ljy980330/51_development_board/README.txt

51开发板项目 GitHub仓库说明

datasheet
    所有的数据手册

hardware
    硬件组项目目录

software
    软件组项目目录

例会讲稿
    每次例会用到的文件

开支
    项目开支流水
