ljy980330/51_development_board/software/初级例程/015 ADC/readme.txt

delay.c :	延迟功能所用到的函数
ADC：	ADC转换的初始化与实现函数
