ljy980330/51_development_board/software/初级例程/021 步进电机/readme.txt

display：		数码管对应的函数
stepperMotor：	步进电机对应的函数
