ljy980330/51_development_board/software/初级例程/017 DAC/readme.txt

PWM文件夹是用来储存AD转换初始化以及输出数据的C源码与头文件

dalay文件夹是用于存放公用的延时函数

Listings文件夹包含了编译所有中间文件

Objects文件夹包含了编译出来的文件（包括最终烧录进单片机的hex文件）

LEDindicator.uvproj 是该程序的工程文件

config.h包含了所有的类型的声明和定义

includes.h包含了所有的头文件

main.c是主函数C源码
