ljy980330/51_development_board/software/初级例程/012 温度传感器/readme.txt

code_tab：	16进制数组存放
function：	OLED模块功能
drive：		数据采集和系统初始化
display：		OLED屏幕显示
i2c：		I2C通信驱动模块
