ljy980330/51_development_board/software/底层驱动/001 I2C驱动/readme.txt

i2c驱动程序

delay：
		延时函数
		
i2c_set:
		i2c初始化以及信号发送和读写字节
