ljy980330/51_development_board/software/中级例程/001 I2C协议-OLED屏幕/readme.txt

OLED屏幕显示

code_tab:
		屏幕显示的值
		
delay：
		延时
		
display：
		屏幕显示
		
function：
		屏幕写命令，写数据，设置坐标，全屏模式，复位
		
i2c：
		i2c通信协议
		
OLED_Init:
		屏幕初始化
