ljy980330/51_development_board/software/高级例程/003 万年历/readme.txt

rtc	:时钟模块
oled	:屏幕模块
iic	:i2c驱动
delay	:延迟函数
