ljy980330/51_development_board/software/中级例程/002 SPI协议-无线模块/send/readme.txt

send_main：发送函数
receive_main：接受函数
spi：spi驱动
UART：UART驱动
