ljy980330/51_development_board/hardware/190711/STC12C5A60S2/20190522.PcbDoc.htm

Reporting Options

# File in Previous Format

Date | : | 2019/9/7
Time | : | 12:32:29
Filename | : | D:\Users\DELL\Documents\GitHub\51_development_board\hardware\190711\STC12C5A60S2\20190522.PcbDoc

Version | Warning

This file was generated by an earlier version of the software
