ljy980330/51_development_board/hardware/190726/STC12底板 190726/STC12C5A60S2底板.PcbDoc.htm

Reporting Options

# File in Previous Format

Date | : | 2019/9/6
Time | : | 19:30:06
Filename | : | D:\Users\DELL\Documents\GitHub\51_development_board\hardware\190726\STC12뒀겼 190726\STC12C5A60S2뒀겼.PcbDoc

Version | Warning

This file was generated by an earlier version of the software
