ljy980330/51_development_board/hardware/190715/STC12底板 190715/STC12C5A60S2底板.PcbDoc.htm

Reporting Options

# File in Previous Format

Date | : | 2019/9/6
Time | : | 20:45:48
Filename | : | D:\节能院\51开发板项目\github\51_development_board\hardware\190715\STC12底板 190715\STC12C5A60S2底板.PcbDoc

Version | Warning

This file was generated by an earlier version of the software
