ljy980330/51_development_board/software/项目分配.docx

1) 点亮一个LED灯...........................................剑桥
2) LED灯闪烁
3) LED流水灯
4) 蜂鸣器
5) 独立按键
6) 外部中断
7) 定时器中断
8) 红外模块
9) 静态数码管显示
10) 动态数码管显示
11) 超声波模块
12) 光敏……………………………………………………………思茹
13) ADC
14) DAC
15) PWM
16) 呼吸灯
17) 直流电机
18) 步进电机
19) RGB灯………………………………………………………..燕婷
20) I2C协议-OLED屏幕
21) OLED屏幕显示ASCII码
22) OLED屏幕显示中文
23) OLED屏幕显示图案
24) 屏幕+温度显示
25) 屏幕+RTC显示
26) 蓝牙通信……………………………………………………..彦钊
27) 电子秒表
28) 万年历
29) 智能小车
30) RTC时钟
31) RTC时钟驱动
32) SPI协议-无线模块
33) SPI驱动
34) 串口通信………………………………………………………大鹏
35) I2C驱动
36) UART驱动
37) 温度传感器
38) 温度传感器驱动
