ljy980330/51_development_board/software/readme.txt

github上只上传工程和源文件，所有的编译中间问价和输出文件都提前删掉

keilkilll.bat：每次编译后上传前使用，清除中间文件，缩小工程（直接点击即可）

STC12C5A.H放到keil目录下的\\C51\INC！！
