ljy980330/51_development_board/hardware/190726/read me.txt

  1、底板使用共阴极数码管，软件组程序写的是共阳极。先前在画模块的时候，使用的是共阳数码管，所以在调试的时候可以使用先前打的模块
  2、DS3231芯片的封装图选错与买回来的芯片尺寸不一样
  3、在原理图转PCB时没有把74HC138第六引脚的VCC转过去，导致LED无法正常点亮
  4、步进电机第五个引脚没有接上VCC，蜂鸣器需要加一个4.7KΩ的电阻再接上电源
  5、AD转换模块中，由于在AO口接了电阻，导致输出的电压减小，这样使得AD转换无法正常工作
  6、电源开关原本位于核心板的正上方，导致不方便使用底板的电源开关，故把电源开关往左挪
  7、独立按键的K3使用P4^7口，需要在烧录的时候把烧录界面的复位脚用作IO的选项勾选上
  8、DHT11的DATA脚需要上拉一个4.7K的电阻，否则无法正常使用该模块
  9、由于超声波程序中用到了外部中断0，故把外部中断的按键去掉
