ljy980330/51_development_board/software/中级例程/003 RGB灯/readme.txt

RGB颜色显示
	
	delay：
		延时
	display：
		不同模式的颜色闪烁
