ljy980330/51_development_board/例会讲稿/0704/例子/readme.txt

XXX例程

delay:
    存放延时模块的文件
ir:
    存放红外模块的文件
smgdisplay:
    存放数码管模块的文件
config.h
    变量重定义头文件
includes.h
    所有头文件的集合
main.c
    主函数
