ljy980330/51_development_board/例会讲稿/0313/0313-hardware.txt

硬件组

1.分配好组员的任务，下发模块，以模块为基础研发我们集成进开发板的电路（分配好之后，将模块对应的组员名字发给我）
2.给出最小系统的设计框图（集成USB烧录功能）
3.给出开发板电源设计的方案（包括防反接，过压，过流，短路的保险措施）
4.先做我们没有购买的模块，比如流水灯，独立按键，红外
