ljy980330/51_development_board/例会讲稿/0327/0327第一阶段总结.pptx

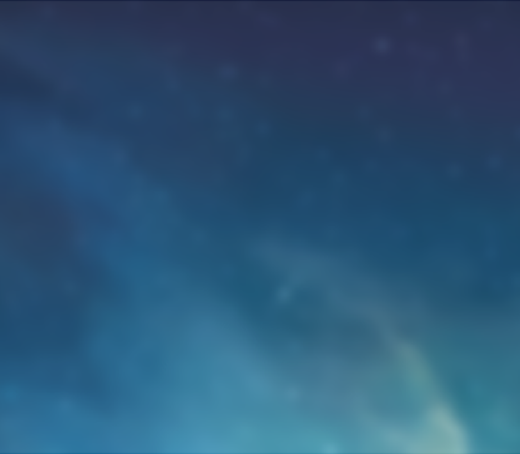
[picture p7: figure]

2019.3.27

51开发板项目
第一阶段总结报告

—梁敬彦

## Slide 2

01

方案进度

02

人员安排

03

软件设计

04

硬件设计

05

未来计划

Your life can be enhanced, and your happiness enriched, when you choose to change your perspective.

## Slide 3

01

方案进度

## Slide 4

01

方案概述

LOGO

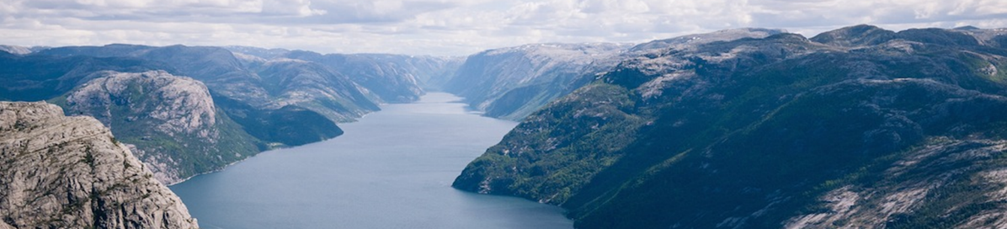
[picture p8: figure]

MCU

该方案使用STC12C5A60S2作为主控芯片，使用外围芯片及电路搭建开发板硬件环境，配套提供软件例程代码。

硬件组
负责开发板的原理图及PCB设计，其中较为复杂的电源方案由组长与副组长给出（包括防反接，过压，过流，短路的保险措施），使用模块化的设计，先测试单个模块，再进行开发板集中组合。

软件组
负责配套例程，底层驱动的设计。使用模块化的设计，各组员负责自己分配的模块，不会出现重复开发的情况。每个模块的软件设计都会生成程序流程图或系统框图。

## Slide 5

01

方案意义

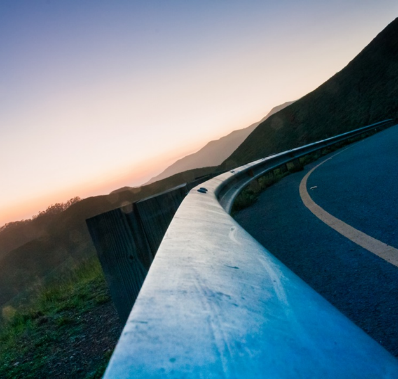
[picture p9: figure]

LOGO

对于大一

参与项目可以学到更多的知识，增强自己的能力

对于大二

不仅需要解决一些高难度的问题，同时作为小组长，如何管理自己的小队也是对自己的一种挑战

对于大三

作为项目组坚实后盾，技术过硬，起着项目带头引导作用

对于节能所

开发板完成后，可以作为后进新生的学习样机，是实验室良性循环不可或缺的一部分

## Slide 6

01

计划进度

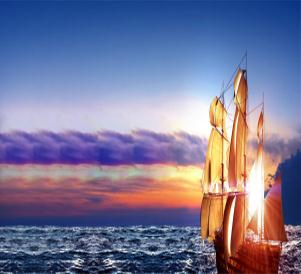
[picture p10: figure]

LOGO

规划、计划阶段

2019.03.01-2019.03.31

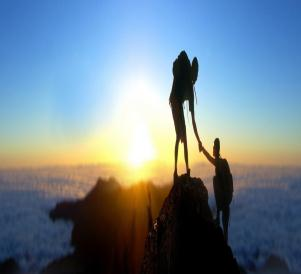
[picture p11: figure]

软硬件开发阶段

2019.04.01-2019.06.30

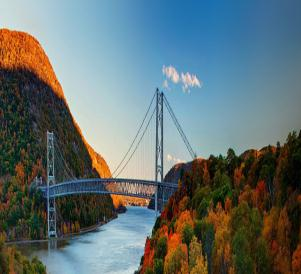
[picture p12: figure]

测试阶段

2019.07.01-2019.08.31

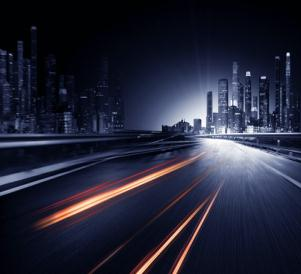
[picture p13: figure]

投产使用阶段

2019.09.01-

## Slide 7

02

人员安排

## Slide 8

01

分组安排

LOGO

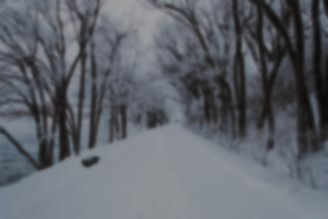
[picture p14: figure]

大三（总负责人）

向指导老师汇报完成进度及项目情况。
推动项目的进行，规划各个小组的设计任务，把握项目的整体走向。对所有元器件进行选型及采购。

大二（小组长）

向总负责人汇报完成进度及项目情况。
软件组：负责高级例程、底层驱动代码的编写
硬件组：负责整机的原理图和PCB设计，汇总组员的设计结果。
测试组：负责压力测试和极限测试，汇总组员的测试结果。

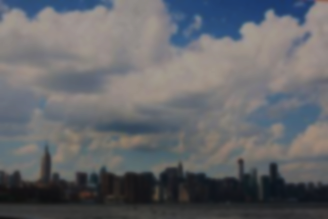
[picture p15: figure]

大一（组员）

向小组长汇报完成进度及项目情况。
软件组：负责中级、初级例程代码的编写
硬件组：负责单个模块的原理图和PCB设计
测试组：负责测试单个模块的性能指标

## Slide 9

01

人员安排

LOGO

部门 | 职位 | 人员信息
软件组 | 组长 | 张大鹏
| 副组长 | 詹锌铠 黄彦钊
| 组员 | 曾思茹 吴彦婷 黄剑桥
硬件组 | 组长 | 林彦妤
| 副组长 | 彭星天 郑泽鹏
| 组员 | 李诗琪 陈建洲
测试组 | 暂无 | 暂无

说明：测试组人员由暑假留校人员组成

## Slide 10

03

软件设计

## Slide 11

03

软件例程

LOGO

04

高级例程

蓝牙通信，万年历，智能小车等4个例程

02

初级例程

流水灯，蜂鸣器，中断等21个例程

05

底层驱动

I2C，SPI，UART等5个驱动

01

准备教程

包括keil软件的安装、CH340驱动安装、如何使用ISP软件烧写程序。

03

中级例程

OLED屏幕等8个例程

## Slide 12

03

硬件组汇报

LOGO

下面由软件组组长进行项目汇报

## Slide 13

04

硬件设计

## Slide 14

03

各模块设计

LOGO

计划在开发板上实现14个功能模块，包括数码管、流水灯、步进电机、蜂鸣器、独立按键、温度传感器、红外接收器、RTC时钟、超声波、无线接收、UART、USB烧录、ADC采集、OLED显示、光敏DAC采集、RGB灯。

陈建州

数码管模块
步进电机模块
RTC模块

李诗琪

流水灯模块
蜂鸣器模块
独立按键模块
红外模块

林彦妤

温度模块
光敏模块
RGB灯模块

彭星天

烧录模块
其他

## Slide 15

03

硬件组汇报

LOGO

下面由硬件组组长进行项目汇报

## Slide 16

05

未来计划

## Slide 17

02

未来计划

LOGO

75%

15%

ADD YOUR TITLE

软件组长
完成中级及高级例程的代码编写，绘制程序流程图。并指导组员完成初级例程的编写。
在完成功能的基础上要争取无软件BUG。

ADD YOUR TITLE

软件组员
完成初级例程，做好注释，代码规整。各组员之间互相协助，有问题多问，在完成项目的同时巩固自己的基础。

50%

ADD YOUR TITLE

硬件组长
完成电源的制作及验证，确保电源的安全性和高效性。组合各个模块，分配好开发板的资源空间（包括布局美观，使用方便，不易损坏，走线合理性）。并指导组员完成各模块的设计。

60%

ADD YOUR TITLE

硬件组员
完成各模块的硬件设计任务，确保模块在硬件上没有问题，并交由软件组进行开发及测试。加强自己在硬件设计及PCB layout方面的能力。

## Slide 18

2019.3.27

THANK YOU
