ljy980330/51_development_board/例会讲稿/0529/0529硬件组第三次报告.pptx

## 硬件组五月汇报

2019.5.29

## 进度：

- 电压正常输入5V，电流为4mA
- 最大耐压值为9V，电流为10mA
- 当输入电压为10V的时候，电流突破20mA,芯片烧坏
- 核心板的冷启动失败

## 解决方案:

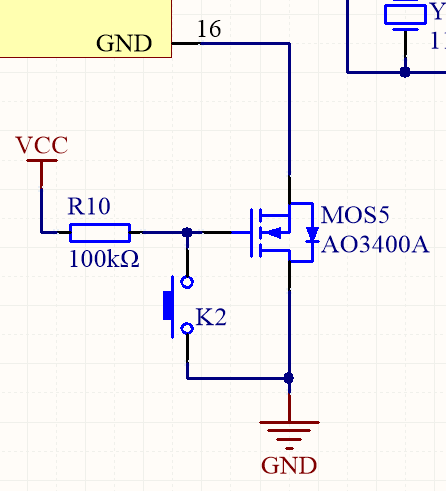
[picture p22: figure]

## Slide 4

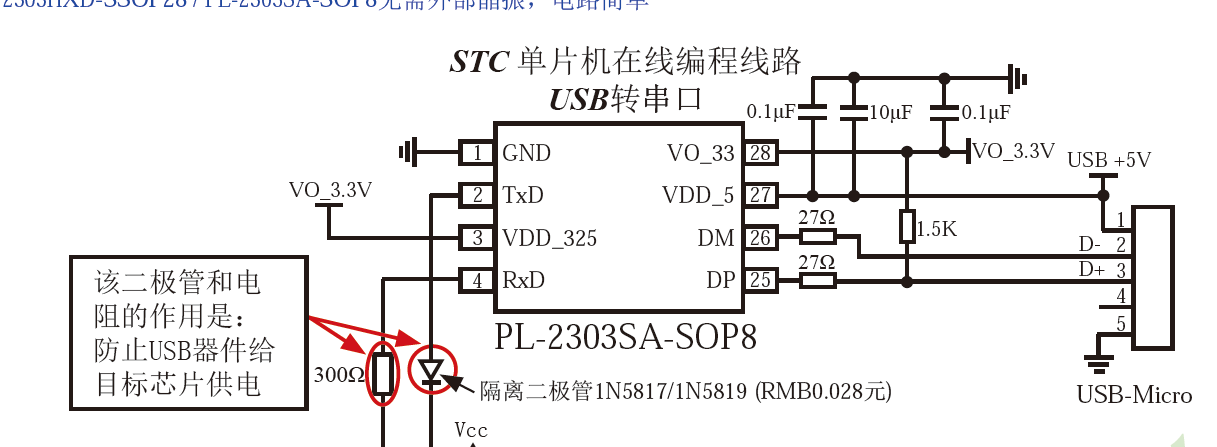
[picture p23: figure]

## Slide 5

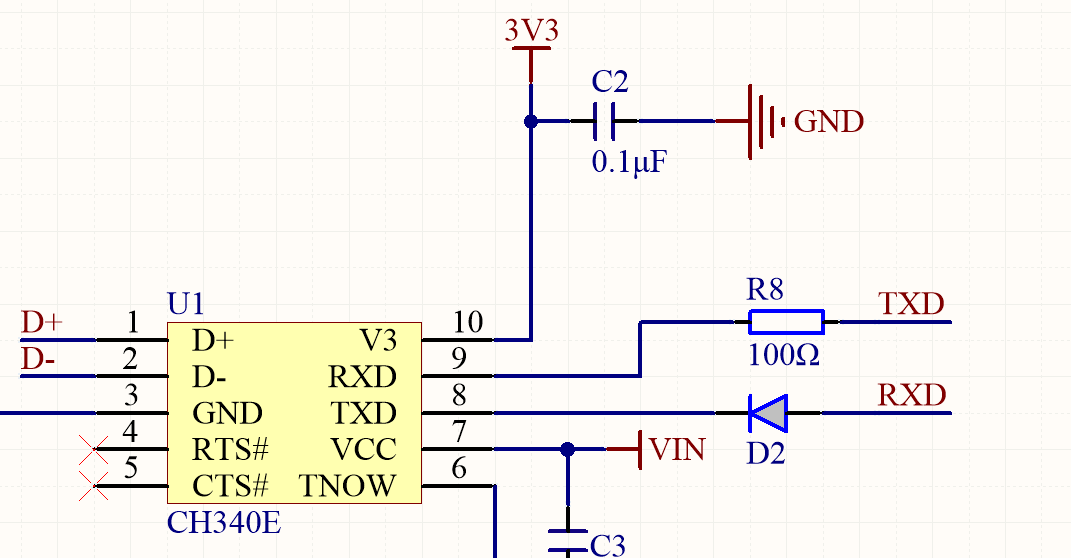
[picture p24: figure]

## 总结：

- 底板
- 手册
