ljy980330/51_development_board/开支/详细清单/硬件组第1次购买材料 3.11.xlsx

元器件 | 参数 | 数量 | 单价 | 总价 | 购买链接
优信购买
OLED显示屏模块 | 0.96寸 IIC | 4 | 16.135 | 64.54 | https://m.tb.cn/h.3Ds9oXR?sm=391961
光敏电阻传感器模块 |  | 4 | 1.5525 | 6.21 | https://m.tb.cn/h.3DsjZnL?sm=f205f2
RGB模块 |  | 4 | 1.65 | 6.6 | https://m.tb.cn/h.3xVr0V7?sm=de2ad7
蜂鸣器 | 5V，有源 | 4 | 1.505 | 6.02 | https://m.tb.cn/h.3x41jvs?sm=b87dd2
步进电机模块 |  | 4 | 1.9425 | 7.77 | https://m.tb.cn/h.3DHdRLG?sm=5ed993
数码管 |  | 4 | 5.3875 | 21.55 | https://item.taobao.com/item.htm?spm=a1z10.3-c-s.w4002-21223910208.42.e07c6a4betCJZ7&id=522572326758
RGB全彩 |  | 1 | 1.17 | 1.17 | https://item.taobao.com/item.htm?spm=a1z10.3-c-s.w4002-21223910208.36.3e9c6a4beWkvle&id=522576144843
nrf24l01 |  | 4 | 4.515 | 18.06 | https://item.taobao.com/item.htm?spm=a1z10.3-c-s.w4002-21223910208.25.24c16a4bXjGfV0&id=522572193384
CH340 C |  | 2 | 1.4 | 2.8 | https://item.taobao.com/item.htm?spm=a1z10.3-c-s.w4002-21223910208.17.63036a4bWoG4DA&id=572355836370
温湿度传感器模块 |  | 4 | 5.145 | 20.58 | https://item.taobao.com/item.htm?id=522553143872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
DHT11 |  | 4 | 5 | 20 | https://item.taobao.com/item.htm?spm=a1z10.3-c-s.w4002-21223910208.14.36e16a4bFlyBWX&id=522576228118
DS3231时钟模块 |  | 4 | 6.3875 | 25.55 | https://item.taobao.com/item.htm?id=551822867339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
DS3231SN |  | 4 | 7.5525 | 30.21 | https://item.taobao.com/item.htm?spm=a1z10.3-c-s.w4002-21223910208.17.3c1c6a4bUAigDA&id=522578232007
税额 |  |  |  | 6.94
小计 |  |  |  | 238
立创商城购买
AT24C32 |  | 4 | 1.35 | 5.4 | https://item.szlcsc.com/117924.html
LM393 |  | 10 | 0.266 | 2.66 | https://item.szlcsc.com/327646.html
uln2003a |  | 10 | 0.8 | 8 | https://item.szlcsc.com/193127.html
595驱动 |  | 10 | 0.686 | 6.86 | https://item.szlcsc.com/6413.html
S8550 | pnp | 50 | 0.1 | 5 | https://item.szlcsc.com/2504.html
小计 |  |  |  | 27.92
