ljy980330/51_development_board/开支/详细清单/硬件组第2次购买材料 4.13.xlsx

元器件 | 参数 | 数量 | 单价 | 总价 | 链接
优信
覆铜板 | 7*10 | 10 | 0.68 | 6.8 | https://item.taobao.com/item.htm?spm=a1z10.3-c-s.w4002-21223910208.9.3a666a4b99Il8e&id=561643459949
覆铜板 | 10*15 | 5 | 1.2 | 6
蜂鸣器 | 有源、9*5.5 | 4 | 0.79 | 3.16 | https://item.taobao.com/item.htm?spm=a1z10.3-c-s.w4002-21223910208.40.4c686a4buZTaPg&id=530577382694
XHB2.54插座 | 5P | 1 | 0.64 | 0.64 | https://item.taobao.com/item.htm?spm=a1z10.3-c-s.w4002-21223910208.10.7e6d6a4bwBwW11&id=586449371313
4.7k贴片排阻 |  | 1 | 4 | 4 | https://item.taobao.com/item.htm?spm=a1z10.3-c-s.w4002-21223910208.12.5d696a4bNlhSHf&id=522577240158
CR1220纽扣电池座 |  | 5 | 0.36 | 1.8 | https://item.taobao.com/item.htm?spm=a1z10.3-c-s.w4002-21223910208.22.b66c6a4bqbp6us&id=522578092106
CR1220纽扣电池 |  | 1 | 2.4 | 2.4 | https://item.taobao.com/item.htm?spm=a1z10.3-c-s.w4002-21223910208.34.b66c6a4bqbp6us&id=522574814712
数码管 | 0.36、共阴4位 | 4 | 1.01 | 4.04 | https://item.taobao.com/item.htm?spm=a1z10.3-c-s.w4002-21223910208.9.4ae66a4bW7TXQr&id=558532329720
LED | 0603 | 2 | 2 | 4 | https://item.taobao.com/item.htm?spm=a1z10.3-c-s.w4002-21223910208.31.4afb6a4bBP9mnu&id=526211410115
LED | 0805 | 2 | 1.4 | 2.8 | https://item.taobao.com/item.htm?spm=a1z10.3-c-s.w4002-21223910208.28.3bd56a4byey02w&id=570332264693
电容 | 0805、1μF | 1 | 3.5 | 3.5 | https://item.taobao.com/item.htm?spm=a1z10.3-c-s.w4002-21223910208.10.11fa6a4bcZAtSw&id=572619409722
电容 | 0805、10μ | 1 | 6 | 6 | https://cart.taobao.com/add_cart_succeed.htm?_input_charset=gb18030&spm=2013.1.20140002.d2.undefined
3.3v稳压管 |  | 1 | 1.5 | 1.5 | https://item.taobao.com/item.htm?spm=a1z10.3-c-s.w4002-21223910208.10.65d36a4bRquDi8&id=522556851098
贴片按键 | 3.8mm | 1 | 1 | 1 | https://item.taobao.com/item.htm?spm=a1z10.3-c-s.w4002-21223910208.36.453c6a4b0q1woc&id=557629497365
拨动开关 | 贴片 | 1 | 2.2 | 2.2 | https://item.taobao.com/item.htm?spm=a1z10.3-c-s.w4002-21223910208.10.65966a4bMIjd1g&id=569515111460
晶振 | 直插、11.05926 | 1 | 2 | 2 | https://item.taobao.com/item.htm?spm=a1z10.3-c-s.w4002-21223910208.12.38eb6a4baREkMP&id=522574689913
micro usb |  | 5 | 0.14 | 0.7 | https://item.taobao.com/item.htm?spm=a1z10.3-c-s.w4002-21223910208.36.12086a4bdvYCRd&id=538147753981
2.54排针 | 20p | 5 | 0.99 | 4.95 | https://item.taobao.com/item.htm?spm=a1z10.3-c-s.w4002-21223910208.22.f7c86a4bS5X9hr&id=553875848479
语音模块 |  | 1 | 56 | 56
74HC138 |  | 5 | 0.71 | 3.55
税金 |  | 1 | 9.77 | 9.77
小计 |  |  |  | 126.81
立创
TL331 |  | 5 | 2 | 10 | https://item.szlcsc.com/82092.html
MOS | AO3400 | 20 | 0.283 | 5.66 | https://item.szlcsc.com/192487.html
MOS | SI2301 | 20 | 0.183 | 3.66 | https://item.szlcsc.com/192483.html
MOS | 2N7002 | 20 | 0.118 | 2.36 | https://item.szlcsc.com/9040.html
74HC138 |  | 5 | 1.42 | 7.1 | https://item.szlcsc.com/150384.html
小计 |  |  |  | 28.78
