ljy980330/51_development_board/开支/总开支情况.xlsx

2019年51开发板项目开支详情
日期 | 名称 | 单价 | 数量 | 总价 | 垫付人 | 备注 | 链接
2019.3.1 | STC12最小系统 | 18.5 | 3 | 55.5 | 詹锌铠 | 课程设计报销 | https://item.taobao.com/item.htm?spm=a1z09.2.0.0.29032e8dWnAjuQ&id=536239655550&_u=51pfiddhaa66
2019.3.11 | 优信模块 | 238 | 1 | 238 | 梁敬彦 | SRP报销(190713) | 详见3.11元器件购买表
2019.3.11 | 立创商城IC | 27.92 | 1 | 27.92 | 梁敬彦 | SRP报销(190713) | 详见3.11元器件购买表
2019.4.13 | 立创商城IC | 28.78 | 1 | 28.78 | 梁敬彦 | 国赛报销(190811) | 详见4.13元器件购买表
2019.4.13 | 立创商城IC | 16.31 | 1 | 16.31 | 梁敬彦 | 国赛报销(190811) | 详见4.13元器件购买表
2019.4.13 | 立创商城IC | 10.51 | 1 | 10.51 | 梁敬彦 | 国赛报销(190811) | 详见4.13元器件购买表
2019.4.15 | 优信模块 | 126.81 | 1 | 126.81 | 梁敬彦 |  | 详见4.13元器件购买表
