ljy980330/51_development_board/(list of files, cad)

Other CAD files:
例会讲稿/0704/例子/Objects/main.obj
例会讲稿/0704/例子/Objects/ir.obj
例会讲稿/0704/例子/Objects/smgdisplay.obj
例会讲稿/0704/例子/Objects/delay.obj
