ljy980330/51_development_board/hardware/190726/STC12底板 190726/STC12C5A60S2.PDF

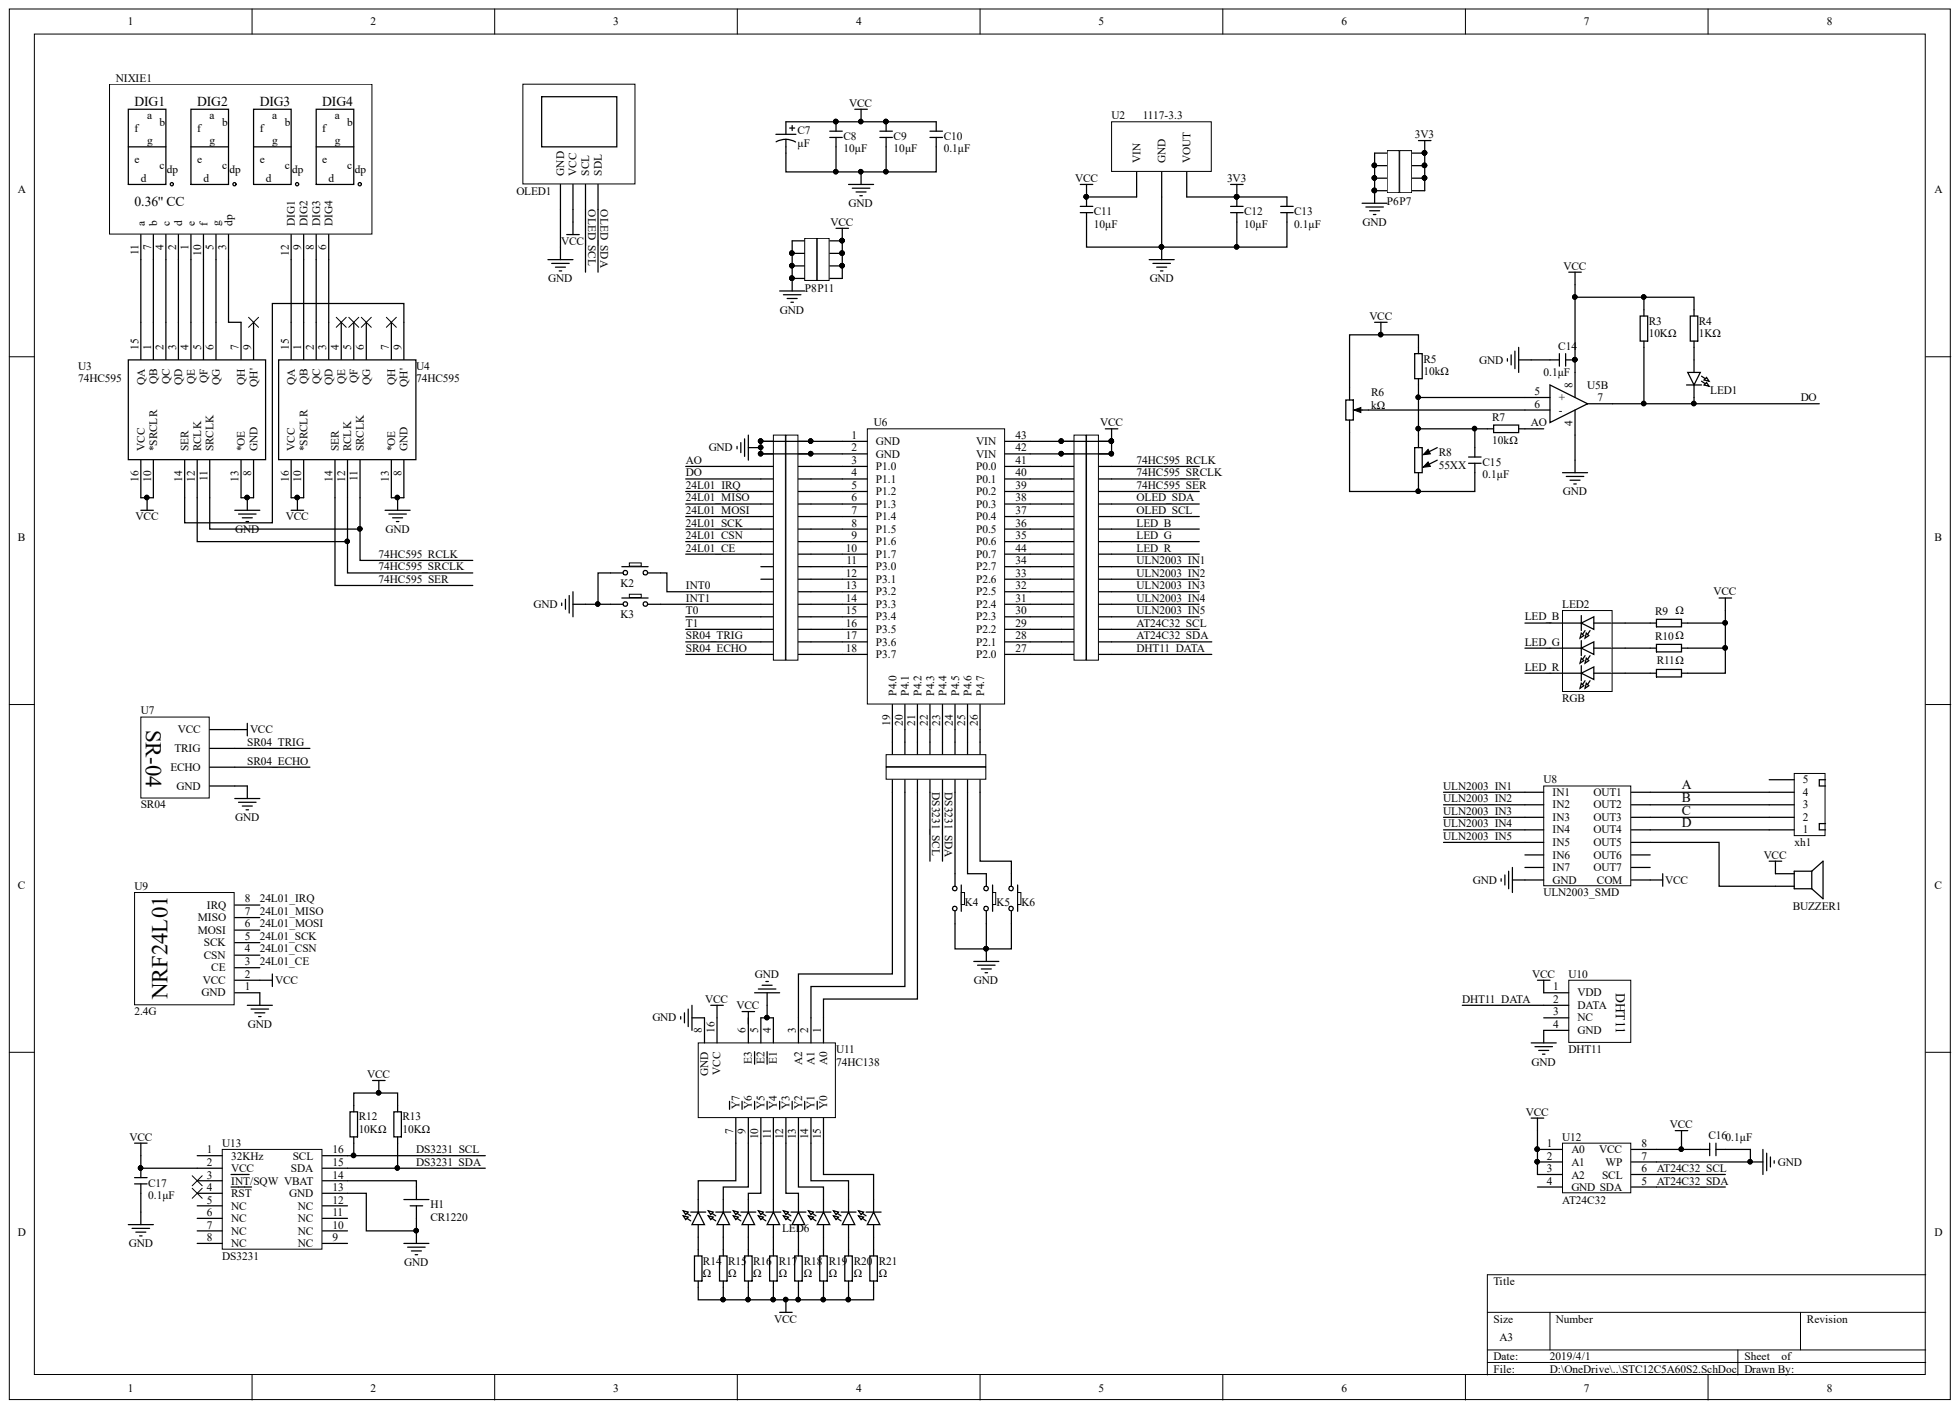
[picture p27: page 1]
