ljy980330/51_development_board/(list of files, drawings)

Other design files:
hardware/190409/stc12核心板/STC12+CH340E.PrjPcb
hardware/190409/stc12核心板/STC12+CH340E.SchDoc
hardware/190409/电源仿真.ms14
hardware/190422/STC12+CH340E/STC12+CH340E.PcbDoc
hardware/190422/STC12+CH340E/STC12+CH340E.PrjPcb
hardware/190422/STC12+CH340E/STC12+CH340E.SchDoc
hardware/190426/STC12+CH340E/STC12+CH340E.PrjPcb
hardware/190426/STC12+CH340E/STC12+CH340E.SchDoc
hardware/190626/最小系统+电源/STC12+DC/STC12+DC.PrjPcb
hardware/190626/最小系统+电源/电源+STC12+ch340(1).SchDoc
hardware/190711/STC12C5A60S2/20190522.PcbDoc
hardware/190711/STC12C5A60S2/STC12C5A60S2 DEMO R1A - 丝印.PcbDoc
hardware/190711/STC12C5A60S2/STC12C5A60S2 DEMO R1A.PcbDoc
hardware/190711/STC12C5A60S2/STC12C5A60S2 DEMO R1A.PrjPcb
hardware/190711/STC12C5A60S2/STC12C5A60S2 DEMO R1A.SchDoc
hardware/190711/STC12C5A60S2/核心板.PcbDoc
hardware/190726/STC12底板 190726/input.SchDoc
hardware/190726/STC12底板 190726/STC12_1.SCHLIB
hardware/190726/STC12底板 190726/STC12C5A60S2.SchDoc
hardware/190726/STC12底板 190726/STC12C5A60S2底板.SchDoc
hardware/190726/STC12底板 190726/STC12开发板.PrjPcb
hardware/190726/STC12底板 190726/STC12开发板.SCHLIB
