ljy980330/51_development_board/software/初级例程/020 直流电机/dcMotor/dcMotor.h

/*********************************************************************************************************
*名称：DCMotor.h
*功能：外部所用到的直流电机函数声明
创建时间：2019/7/8
修改时间：2019/7/8
作者：黄彦钊
*********************************************************************************************************/
#ifndef _DCMOTOR_H
#define _DCMOTOR_H	  
#include "config.h"

void Init_PWM();
void PWM_change();

#endif
