ljy980330/51_development_board/software/初级例程/009 串口2通信/main.c

/*********************************************************************************************************
*名称： main.c
*功能： 打开串口调试助手，自己发送并接收数据16进制数据
		晶振 11.0592
		波特率 	2400
		接收发送都为 HEX
		请勿发送太快
创建时间：2019/7/8
修改时间：2019/7/11
作者：黄彦钊
*********************************************************************************************************/	
#include "includes.h"  
/*******************************************************************************
* 函 数 名         : main
* 函数功能		   : 主函数
*******************************************************************************/
void main()
{	
//	Usart2Init();  //	串口初始化
//	
//	Usart2SendString("STC12 UART2 TEST!\r\n");
//	while(1);		
	
	
	Uart2Init();//初始化9600
	
	Uart2_send_string("STC12 UART2 TEST!\r\n");       //将这个字符串发送
	
	while(1);
}					   
