ljy980330/51_development_board/software/初级例程/007 定时器中断/main.c

/*********************************************************************************************************
*名称：main.c
*功能：通过定时器，每过2s，led灯变换一次
创建时间：2019/7/8
修改时间：2019/7/8
作者：黄彦钊
*********************************************************************************************************/
#include "includes.h"							
					 
/*******************************************************************************
* 函 数 名         : main
* 函数功能		   : 主函数
*******************************************************************************/
void main()
{						 
  P4SW=0xbb;	//定义P4IO口
  init();	   
  while(1);
}
