ljy980330/51_development_board/software/高级例程/001 蓝牙通信/main.c

/*********************************************************************************************************
*名称：蓝牙模块
*功能：单片机与手机通过蓝牙发送与接收字符
创建时间：2019/7/5
修改时间：2019/7/5
作者：黄彦钊
*********************************************************************************************************/

#include "includes.h" 
/*******************************************************************************
* 函 数 名         : main
* 函数功能		   : 主函数
*******************************************************************************/
void main()
{
	 BlueteethInit();	  
	 while(1)
	 {  
	      ;
	 }		
}
