ljy980330/51_development_board/software/底层驱动/003 UART驱动/main.c

/*********************************************************************************************************
*名称：串口通信
*功能：在串口助手窗口进行串口数据收发检测
创建时间：2019/7/5
修改时间：2019/XX/XX
作者：李诗琪
*********************************************************************************************************/

#include "includes.h"

uchar num;

int main()
{
	UART_Init();	//串口初始化
	while(1);
}

void UART() interrupt 4
{
	UART_Interrupt();	
}
