ljy980330/51_development_board/software/中级例程/001 I2C协议-OLED屏幕/main.c

/*********************************************************************************************************
*名称：OLED显示屏
*功能：在屏幕中显示
创建时间：2019/7/5
修改时间：2019/XX/XX
作者：李诗琪
*********************************************************************************************************/

#include "includes.h"

int mian()
{
	OLED_Init();	//OLED初始化

	while(1);
}
