ljy980330/51_development_board/software/中级例程/005 OLED屏幕显示中文/main.c

/*********************************************************************************************************
*名称：OLED显示屏
*功能：在屏幕中显示汉字
创建时间：2019/7/7
修改时间：2019/XX/XX
作者：李诗琪
*********************************************************************************************************/
#include "includes.h"

int main(void)
{
	U8 i;
	OLED_Init();
	
	while(1)
	{
	
		OLED_P16x16Ch(24,0,1);

		OLED_P16x16Ch(40,0,2);

		OLED_P16x16Ch(57,0,3);

		OLED_P16x16Ch(74,0,4);

		OLED_P16x16Ch(91,0,5);

		for(i=0; i<8; i++)//通过点整显示汉字 -- i表示字表数组的位置
		{

			 OLED_P16x16Ch(i*16,2,i+8);

			 OLED_P16x16Ch(i*16,4,i+16);

			 OLED_P16x16Ch(i*16,6,i+24);

		}
		Delay_ms(4000);

		OLED_CLS();//清屏
	}
}
