ljy980330/51_development_board/software/中级例程/006 OLED屏幕显示图案/main.c

/*********************************************************************************************************
*名称：OLED显示屏
*功能：在屏幕中显示图片
创建时间：2019/7/7
修改时间：2019/XX/XX
作者：李诗琪
*********************************************************************************************************/

#include "includes.h"

int main(void)
{
	OLED_Init();
	while(1)
	{
	
		Draw_BMP(0,0,128,8,BMP1);  //图片显示

		Delay_ms(8000);

		Draw_BMP(0,0,128,8,BMP2);

		Delay_ms(8000);
			
		OLED_CLS();
	}
}
