ljy980330/51_development_board/software/初级例程/010 静态数码管显示/main.c

/*****************************************************************************
*名称：静态数码管
*功能：让数码管显示一个数字
创建时间：2019/7/5
修改时间：2019/7/5
作者：黄剑桥
*********************************************************************************************************/
#include "includes.h"
void main()
{
    P1=0x00; //消抖
	while(1)
	{
	DisplayAddr(1);	//让数码管显示1

	}
}
