ljy980330/51_development_board/例会讲稿/0704/例子/main.c

/*********************************************************************************************************
*名称：红外通信
*功能：利用红外遥控在数码管上显示数值 
创建时间：2019/XX/XX
修改时间：2019/6/5
作者：XXX
*********************************************************************************************************/

#include "includes.h"

int main()
{
	IrInit();  //红外模块初始化
	
	while(1)
	{
		DisplayAddr(shuju[IRCOM[5]]); //显示
	}
	
	return 0;
}
