ljy980330/51_development_board/software/初级例程/013 RTC时钟/i2c/i2c.c

/*********************************************************************************************************
*名称：i2c.c
*功能：IO口模拟I2C通信
创建时间：2019/7/5
修改时间：2019/XX/XX
作者：XXX
**********************************************************************************************************/

#include "i2c.h"	
#include "intrins.h"		
#include "../delay/delay.h"


/*******************************************************************************
* 函 数 名         : IIC_Start
* 函数功能		   : i2c开始信号
*******************************************************************************/

void IIC_Start()
{
	SDA = high;
	nop();
	SCL = high;
	nop();
	SDA = low;
	nop();
	SCL = low;
	nop();
}

/*******************************************************************************
* 函 数 名         : IIC_Stop
* 函数功能		   : i2c终止信号
*******************************************************************************/

void IIC_Stop()
{
	SCL = low;
	nop();
	SDA = low;
	nop();
	SCL = high;
	nop();
	SDA = high;
	nop();
}


/*******************************************************************************
* 函 数 名         : Write_IIC_Byte
* 函数功能		   : 通过I2C总线写一个字节
*******************************************************************************/

void Write_IIC_Byte(uchar IIC_Byte)
{
	uchar i;

	for(i=0;i<8;i++)
	{
		if(IIC_Byte & 0x80)
			SDA=high;
		else
			SDA=low;

		SCL=high;

		SCL=low;

		IIC_Byte<<=1;
	}
	SDA=low;
	SCL=high;
	SCL=low;
}
