ljy980330/51_development_board/software/初级例程/013 RTC时钟/config.h

/*********************************************************************************************************
*名称：config.h
*功能：数据类型以及通用变量的声明以及定义
创建时间：2019/7/14
修改时间：2019/XX/XX
作者：XXX
**********************************************************************************************************/

#ifndef _CONFIG_H
#define _CONFIG_H

typedef unsigned char uchar;	//新数据类型的声明定义
typedef unsigned int  uint;

#define FSCLK	11059200	//#define FSCLK	12000000

#endif
