ljy980330/51_development_board/software/初级例程/015 ADC/config.h

/*********************************************************************************************************
*名称：config.h
*功能：数据类型及通用变量的声明和定义 
创建时间：2019/7/5
修改时间：2019/7/27
作者：曾思茹
*********************************************************************************************************/

#ifndef _CONFIG_H
#define _CONFIG_H

typedef unsigned char uchar;	//新数据类型的声明和定义
typedef unsigned int  uint;
typedef unsigned long ulong;

#define FSCLK	11059200	//#define FSCLK	12000000

#endif
