ljy980330/51_development_board/software/初级例程/002 LED灯闪烁/config.h

/*********************************************************************************************************
*名称：config.h
*功能：数据类型及通用变量的声明及定义
创建时间：2019/7/4
修改时间：2019/7/4
作者：黄剑桥
*********************************************************************************************************/

#ifndef _CONFIG_H
#define _CONFIG_H

typedef unsigned char  uchar;	 //新数据类型的声明定义
typedef unsigned int  uint;

#endif
