ljy980330/51_development_board/software/中级例程/002 SPI协议-无线模块/receive/UART/UART.h

/*********************************************************************************************************
*名称：UART_Init.h
*功能：串口初始化用到的头文件和函数声明
创建时间：2019/7/5
修改时间：2019/XX/XX
作者：XXX
*********************************************************************************************************/

#ifndef _UART_H
#define _UART_H

#include "config.h"
#include "STC12C5A.h"

void UART_Init();	 
void UART_Interrupt();
void UART_Send_Byte(uchar byte);

#endif
