ljy980330/51_development_board/software/初级例程/013 RTC时钟/includes.h

/*********************************************************************************************************
*名称：includes.h
*功能：所有的头文件都在这个头文件中进行包含
创建时间：2019/XX/XX
修改时间：2019/6/5
作者：XXX
*********************************************************************************************************/

#ifndef _INCLUDES_H
#define _INCLUDES_H

#include <STC12C5A.H>
#include <intrins.h>		
#include <stdio.h>
#include "config.h"	
#include "i2c/i2c.h"
#include "rtc/rtc.h"
#include "OLED_Init/OLED_Init.h"	
#include "function/function.h"
#include "code_tab/code_tab.h"
#include "display/display.h"  
#include "rtc-oled/rtc-oled.h"   
#include "printf_init/printf_init.h	"  


#endif
