ljy980330/51_development_board/software/初级例程/008 超声波模块/串口显示/includes.h

/*********************************************************************************************************
*名称：includes.h
*功能：所有头文件都在这个头文件内包含 
创建时间：2019/7/5
修改时间：2019/XX/XX
作者：XXX
*********************************************************************************************************/

#ifndef _INCLUDES_H
#define _INCLUDES_H

#include <STC12C5A.H> 
#include "intrins.h"
#include "config.h"	 	
#include "stdio.h"
#include "delay/delay.h" 	  
#include "Ultrasonic/Ultrasonic.h" 	 


#endif
