ljy980330/51_development_board/software/初级例程/009 串口2通信/includes.h

/*********************************************************************************************************
*名称：includes.h
*功能：所有的头文件都在这个头文件中进行包含
创建时间：2019/7/4
修改时间：2019/7/4
作者：黄彦钊
*********************************************************************************************************/

#ifndef _INCLUDES_H
#define _INCLUDES_H

//#include "STC12C5A.H"
#include <STC12C5A60S2.H>
#include "config.h"
#include "serial/serial.h"
#include "delay/delay.h"  

#endif
