ljy980330/51_development_board/software/初级例程/017 DAC/includes.h

/**********************************************************************************
*名称：includes.h
*功能：所有头文件都包含在这个头文件
	创建时间：2019/7/27 
	修改时间：2019年7/29	
	作者：曾思茹
***********************************************************************************/

#ifndef _INCLUDES_H
#define _INCLUDES_H

#include <STC12C5A.H>

#include "intrins.h"
#include "delay/delay.h"
#include "config.h"	  
#include "PWM/PWM.h"


#endif
