ljy980330/51_development_board/software/初级例程/020 直流电机/includes.h

/*********************************************************************************************************
*名称：includes.h
*功能：所有的头文件都在这个头文件中进行包含
创建时间：2019/7/14
修改时间：2019/7/24
作者：黄彦钊
*********************************************************************************************************/

#ifndef _INCLUDES_H
#define _INCLUDES_H

#include "STC12C5A.H"
#include "config.h"
#include "delay/delay.h"  
#include "dcMotor/dcMotor.h"

#endif
