ljy980330/51_development_board/software/底层驱动/004 温度传感器驱动/includes.h

/*********************************************************************************************************
*名称：includes.h
*功能：所有的头文件在这个头文件内被包含
创建时间：2019/7/6
修改时间：2019/XX/XX
作者：李诗琪
**********************************************************************************************************/

#ifndef _INCLUDES_H
#define _INCLUDES_H

#include <STC12C5A.H>
#include "config.h"
#include "intrins.h"
#include "delay/delay.h"
#include "drive/drive.h"

#endif
