ljy980330/51_development_board/software/高级例程/001 蓝牙通信/includes.h

/*********************************************************************************************************
*名称：includes.h
*功能：所有头文件都在这个头文件内包含 
创建时间：2019/7/8
修改时间：2019/7/8
作者：黄彦钊
*********************************************************************************************************/

#ifndef _INCLUDES_H
#define _INCLUDES_H
#include "config.h"
#include <STC12C5A.H>
#include <intrins.h>
#include "delay/delay.h" 
#include "blueTeeth/blueTeeth.h"

#endif
