ljy980330/51_development_board/(commit log)

2019-06-26 190626 init
    [STC12+CH340E.PcbDoc, STC12+CH340E.PrjPcb, STC12+CH340E.SchDoc, STC12+DC.PrjPcb, STC12C5A60S2.SchDoc, STC12C5A60S2底板.SchDoc, STC12开发板.PrjPcb, STC12开发板.SCHLIB]
2019-07-04 update 190704
    [delay.obj, ir.obj, main.obj, smgdisplay.obj]
2019-07-05 changes
    changes
    [OLED_Init.obj, delay.obj, display.obj, function.obj, i2c.obj, i2c_data.obj, i2c_set.obj, ir.obj]
2019-07-06 update
    添加初级例程
    [main.OBJ]
2019-07-07 update 190707
    黄剑桥的初级程序
    [ChaoShengBo.obj, DianliangLED.OBJ, FengMingQi.obj, Key1.obj, LEDshanshuo.obj, buzz.obj, delay.obj, interrupt.obj]
2019-07-07 update 190707
    优化一些代码
    [main.OBJ]
2019-07-09 智能小车初版
    19.7.9
    [color.obj, delay.obj, flame.obj, main.OBJ, pwm.obj, track.obj, voice.obj]
2019-07-09 万年历初版
    [delay.obj, iic.obj, main.OBJ, oled.obj, rtc.obj]
2019-07-09 万年历小改动
    [delay.obj, iic.obj, main.OBJ, oled.obj, rtc.obj]
2019-07-09 蓝牙初版
    [OLED_Init.obj, blueTeeth.obj, color.obj, delay.obj, flame.obj, function.obj, i2c.obj, iic.obj]
2019-07-10 update
    update
    [delay.obj, main.OBJ, spi_set.obj]
2019-07-11 spi，stc（ds3231）初版,更改一些新delay函数
    delay_us
    [delay.obj, main.OBJ, main.obj, rtc.obj, spi.obj, spi_set.obj]
2019-07-14 uart更改
    [UART.obj, UART_Init.obj, UART_Interrupt.obj, main.OBJ, main.obj]
2019-07-14 changes
    修改i2c的串行数据和时钟io口
    [delay.obj, i2c.obj, main.OBJ, main.obj, rtc.obj]
2019-07-14 所有底层驱动，spi_无线模块
    [OLED_Init.obj, UART.obj, code_tab.obj, data_read.obj, delay.obj, display.obj, function.obj, i2c.obj]
2019-07-15 io口修改
    io口修改
    [OLED_Init.obj, code_tab.obj, delay.obj, display.obj, drive.obj, function.obj, i2c.obj, main.OBJ]
2019-07-15 清除中间文件
2019-07-15 驱动，中级
2019-07-15 温湿度驱动修改
2019-07-25 外部中断，定时中断
2019-07-25 串口还没好，超声波
    [UART.obj, Ultrasonic.obj, delay.obj, led.obj, main.obj, send.obj, spi.obj]
2019-07-26 超声波模块1
    [UART.obj, Ultrasonic.obj, delay.obj, led.obj, main.obj, send.obj, spi.obj]
2019-07-26 超声波串口
2019-07-26 update190726
    增添了readme的内容
2019-07-26 update190726
    上传黄剑桥负责的程序
    [delay.obj, main.OBJ, smgdisplay.obj]
2019-07-26 update190726
    加了作者名
2019-07-26 串口通信
    [DianliangLED.obj, Ultrasonic.obj, delay.obj, led.obj, main.obj]
2019-07-26 整理，还没备注
    [DianliangLED.obj, Ultrasonic.obj, delay.obj, led.obj, main.OBJ, main.obj, smgdisplay.obj]
2019-07-26 整合（2）
    [delay.obj, main.obj, stepperMotor.obj]
2019-07-27 update0727
    修改了一些代码，添加了新的readme
2019-07-29 update190729
    增加了用独立按键加减PWM输出占空比的程序
2019-08-11 update 190811
    [总开支情况.xlsx]
2019-08-30 乱码readme改正
2019-09-07 添加stc12c5a.h文件，看readme
    [buzzer.obj, delay.obj, display.obj, led.obj, main.obj, smgdisplay.obj, timerInterrupt.obj]
2019-09-07 无效更新
2019-09-07 190907 deleted .o file
    [buzzer.obj, delay.obj, display.obj, led.obj, main.obj, smgdisplay.obj, timerInterrupt.obj]
2019-09-07 更改led灯io口
2019-09-07 9.7更新（1）
2019-09-07 9.7更改（2）
2019-09-07 update uart2
2019-09-07 9.7更新(3)
2019-09-07 190907 update PWM
